w4tchd0g/phenix-1255-shield/ext_parts/3d/EVQ-Q2Y03W.step

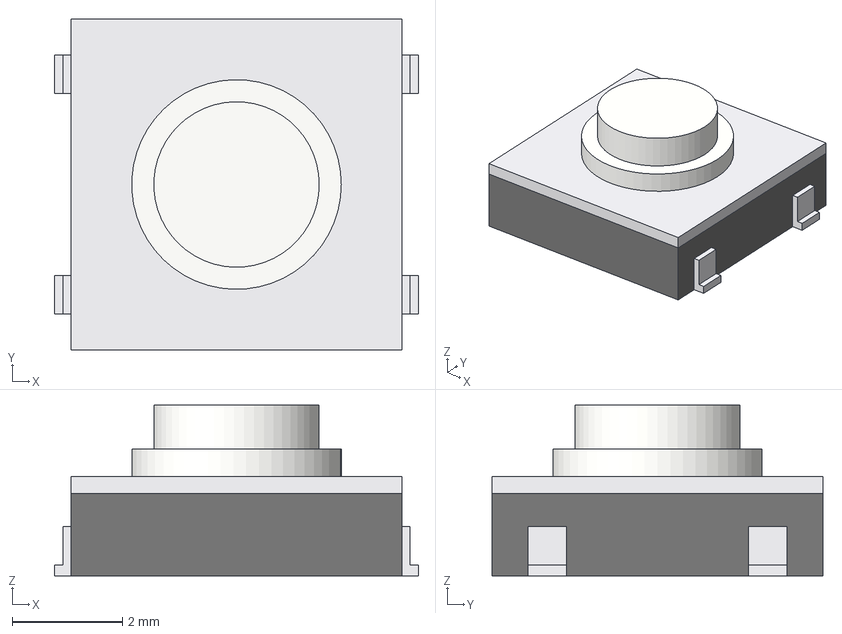
[picture p6: CAD file, 2026-11-12]
ext_parts/3d/EVQ-Q2Y03W.step
6.60 x 6.00 x 3.10 mm
base
cover
push_plate
terminals
