w4tchd0g/phenix-1255-shield/ext_parts/3d/SMA_Samtec_SMA-J-P-H-ST-EM1_EdgeMount.step

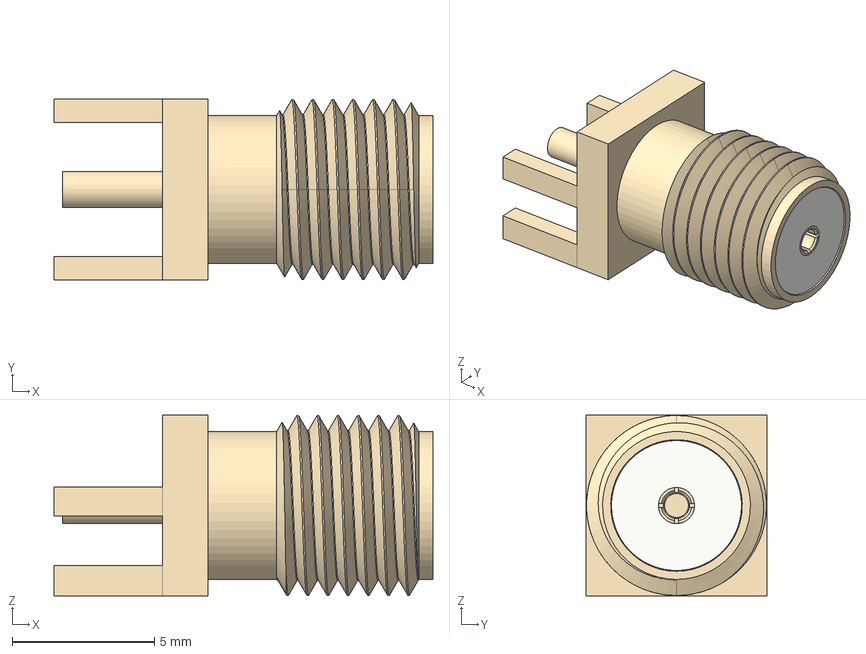
[picture p7: CAD file, 2026-11-12]
ext_parts/3d/SMA_Samtec_SMA-J-P-H-ST-EM1_EdgeMount.step
13.3 x 6.35 x 6.35 mm
insulator_PTFE
socket_contact
