w4tchd0g/phenix-1255-shield/ext_parts/3d/CONSMA001-SMD-G.step

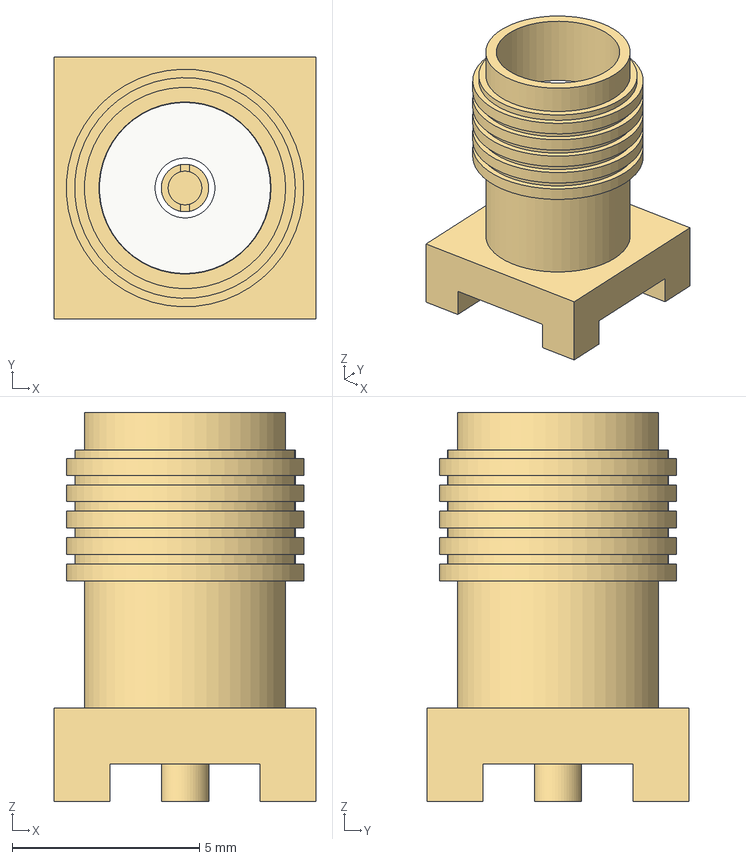
[picture p8: CAD file, 2026-11-12]
ext_parts/3d/CONSMA001-SMD-G.step
7.00 x 7.00 x 10.4 mm
insulator_PTFE
socket_contact
