w4tchd0g/phenix-1255-shield/ext_parts/3d/Display_128x64_096_I2C.stp

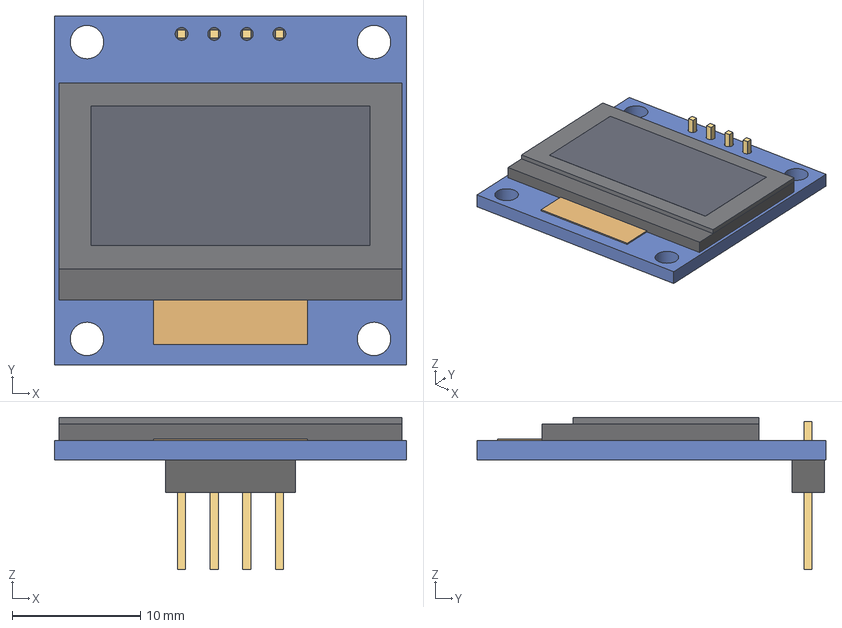
[picture p9: CAD file, 2026-11-12]
ext_parts/3d/Display_128x64_096_I2C.stp
27.4 x 27.2 x 11.9 mm
pcb
glass
cover_glass
active_area
flex
header_body
header_pins
