w4tchd0g/phenix-1255-shield/ext_parts/3d/TA0655A.stp

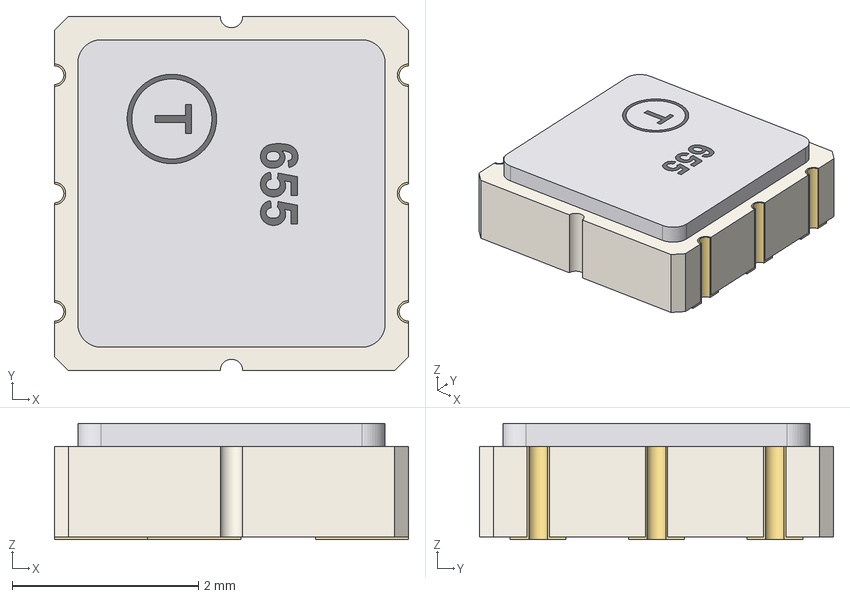
[picture p10: CAD file, 2026-11-12]
ext_parts/3d/TA0655A.stp
3.80 x 3.80 x 1.25 mm
lid
terminals
marking
