w4tchd0g/phenix-1255-shield/ext_parts/3d/TG2520SMN.step

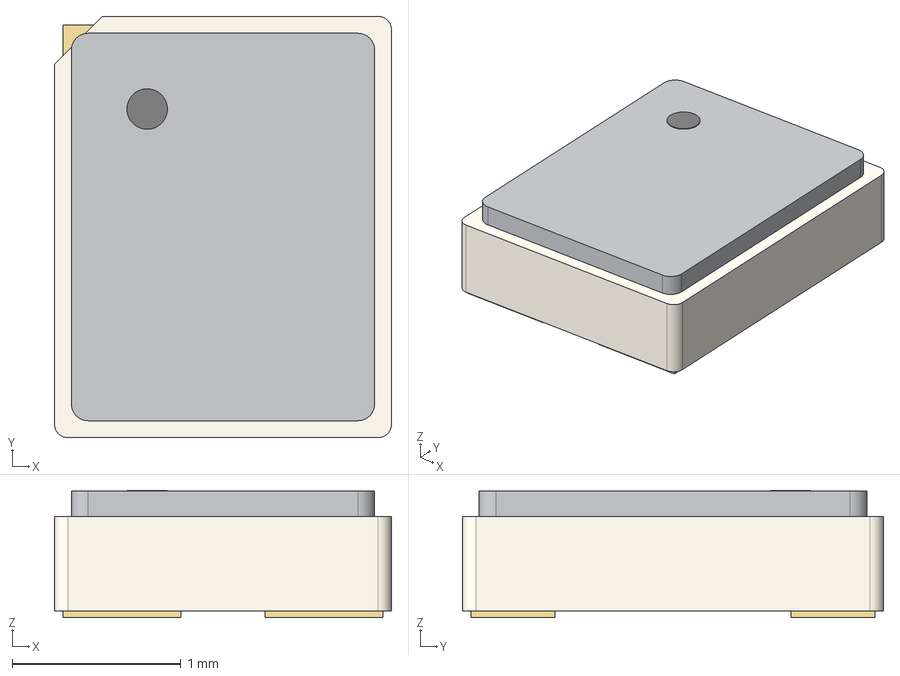
[picture p11: CAD file, 2026-11-12]
ext_parts/3d/TG2520SMN.step
2.00 x 2.50 x 0.755 mm
lid
pin1_mark
pins
