w4tchd0g/phenix-1255-shield/ext_parts/3d/LFCN-490+.step

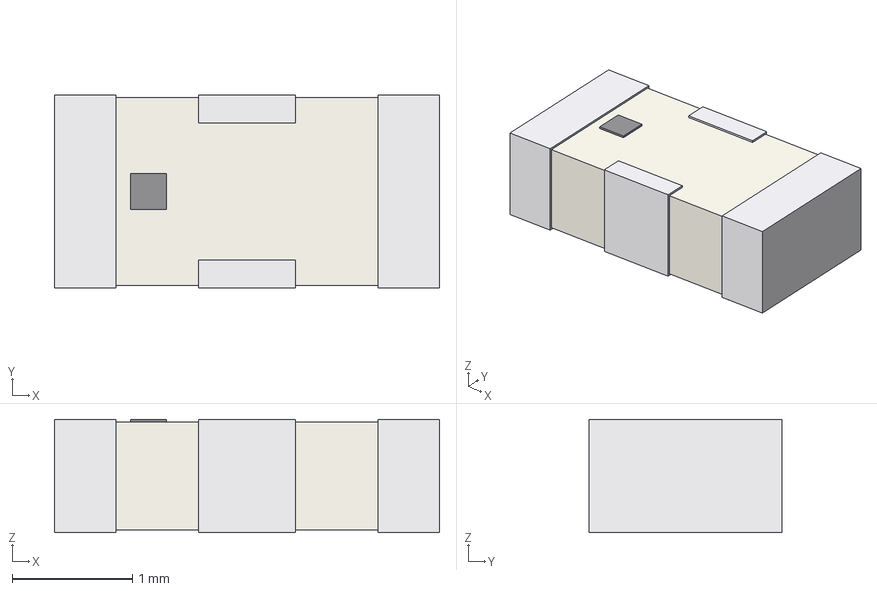
[picture p12: CAD file, 2026-11-12]
ext_parts/3d/LFCN-490+.step
3.20 x 1.60 x 0.94 mm
terminals
index
