w4tchd0g/phenix-1255-shield/phenix-1255-shield.kicad_pcb

## KiCad design phenix-1255-shield.kicad_pcb (2026-11-12)

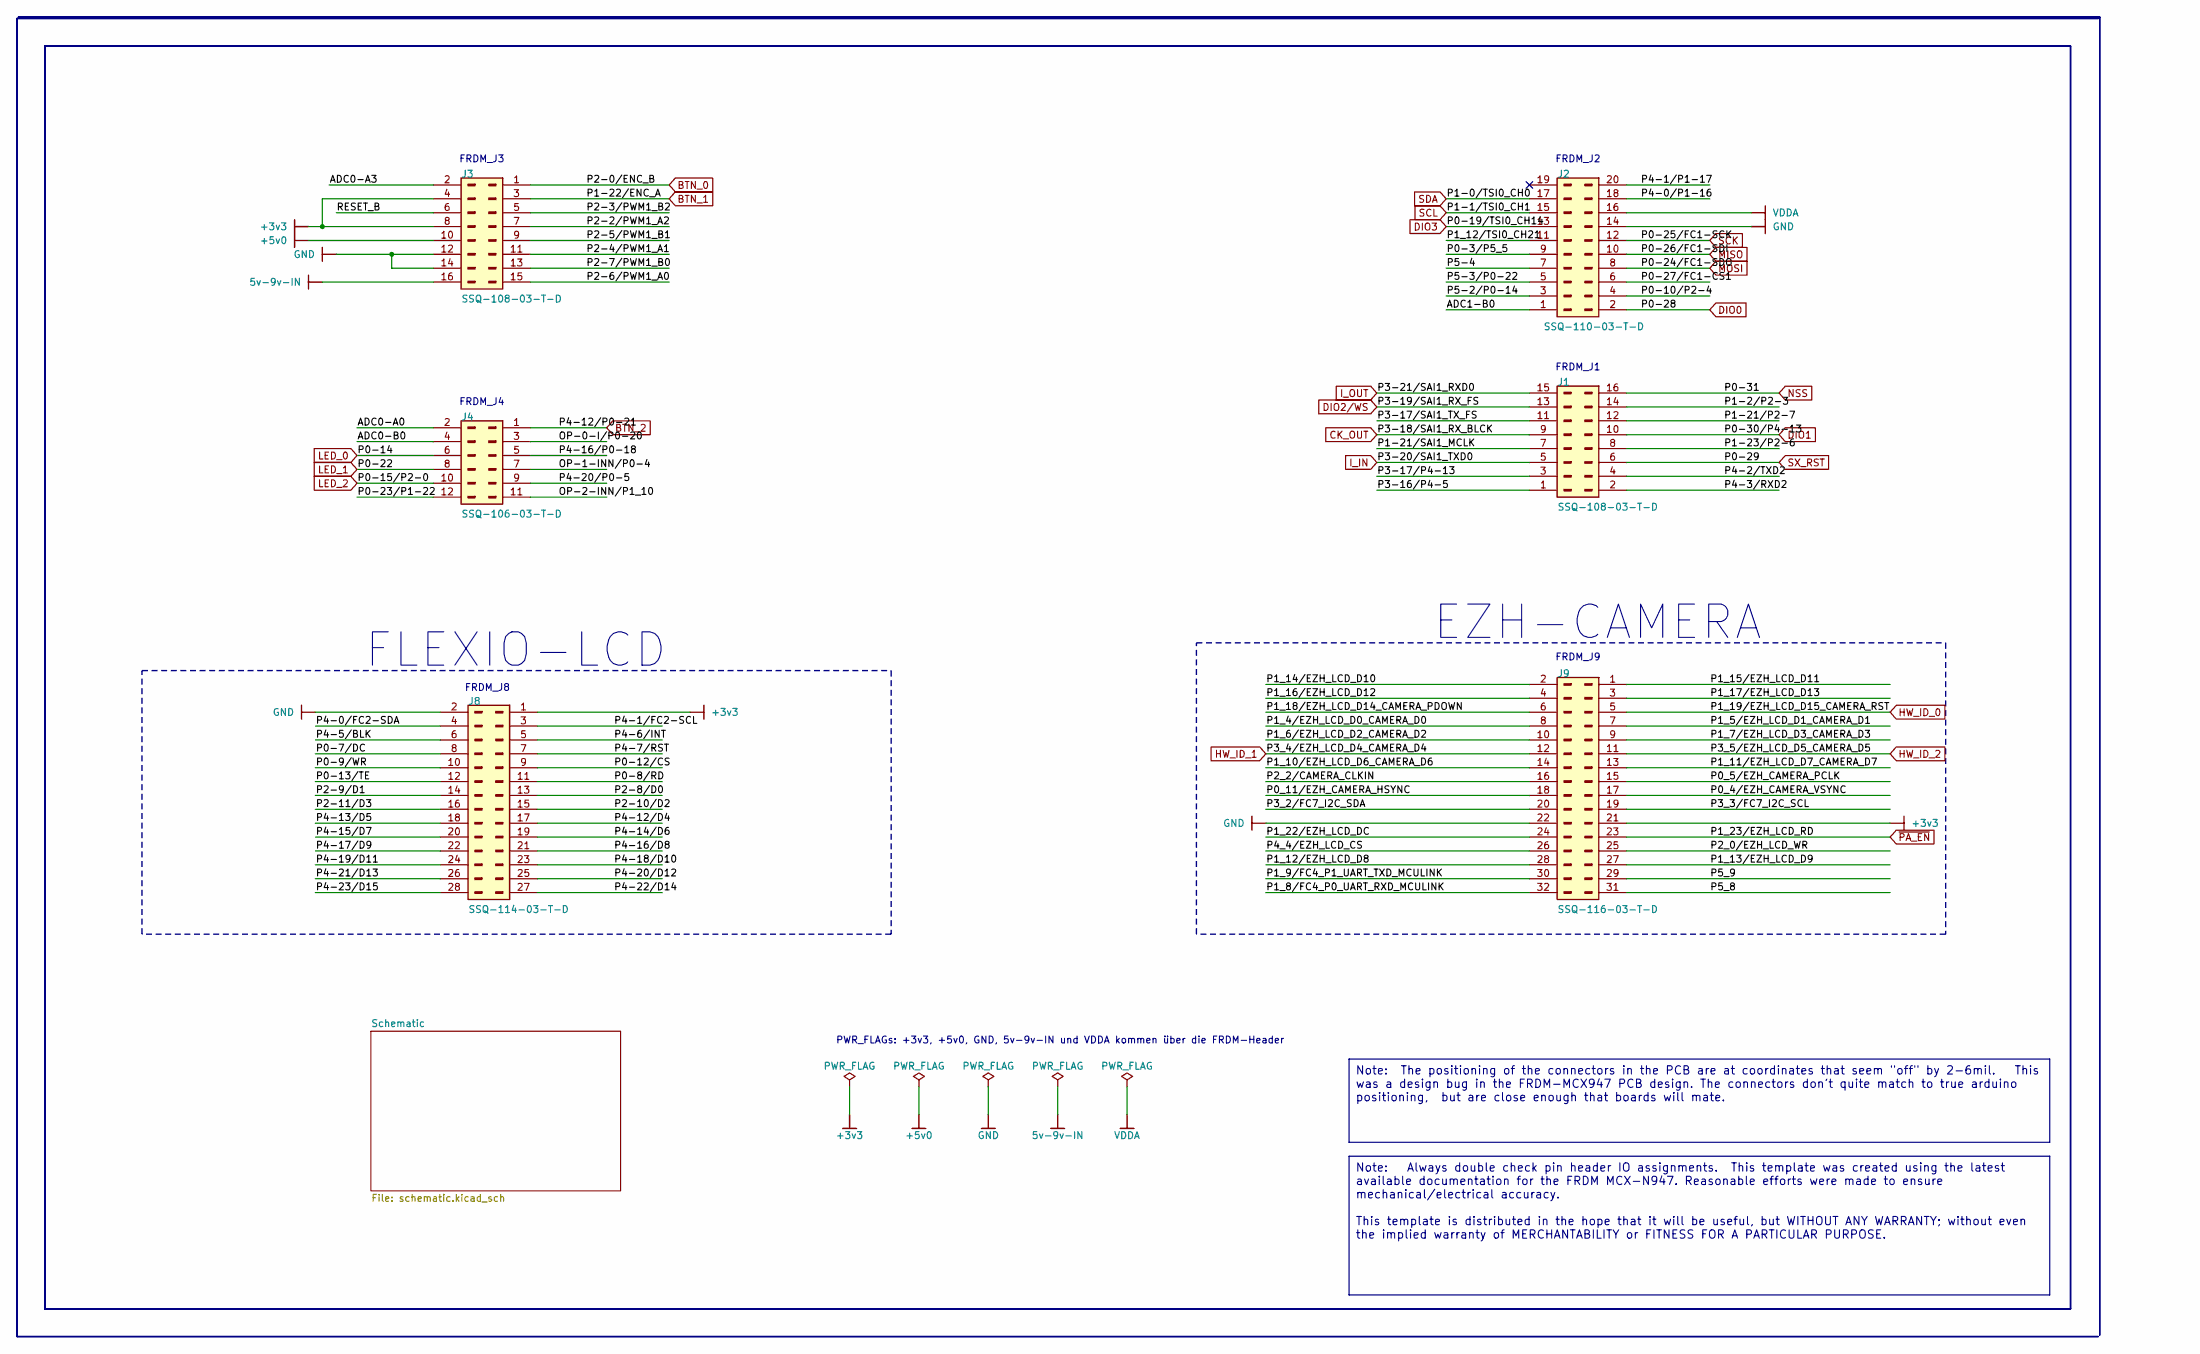
[picture p13: schematic phenix-1255-shield.kicad_sch]

Parts:
J1, J3: SSQ-108-03-T-D; MANUFACTURER PART NUMBER SSQ-108-03-T-D
J2: SSQ-110-03-T-D; MANUFACTURER PART NUMBER SSQ-110-23-T-D
J4: SSQ-106-03-T-D; MANUFACTURER PART NUMBER SSQ-106-03-T-D
J8: SSQ-114-03-T-D; MANUFACTURER PART NUMBER SSQ-114-03-T-D
J9: SSQ-116-03-T-D; MANUFACTURER P/N SSQ-116-03-T-D

Connections:
5v-9v-IN: J3.16
+3v3: J3.4, J3.8, J8.1, J9.21; also elsewhere on the board
+5v0: J3.10; also elsewhere on the board
/ADC0-A0: J4.2
/ADC0-A3: J3.2
/ADC0-B0: J4.4
/ADC1-B0: J2.1
/OP-0-I/P0-20: J4.3
/OP-1-INN/P0-4: J4.7
/OP-2-INN/P1_10: J4.11
/P0-3/P5_5: J2.9
/P0-7/DC: J8.8
/P0-8/RD: J8.11
/P0-9/WR: J8.10
/P0-10/P2-4: J2.4
/P0-12/CS: J8.9
/P0-13/TE: J8.12
/P0-23/P1-22: J4.12
/P0-27/FC1-CS1: J2.6
/P0_4/EZH_CAMERA_VSYNC: J9.17
/P0_5/EZH_CAMERA_PCLK: J9.15
/P0_11/EZH_CAMERA_HSYNC: J9.18
/P1-2/P2-3: J1.14
/P1-21/P2-7: J1.12
/P1-21/SAI1_MCLK: J1.7
/P1-23/P2-6: J1.8
/P1_4/EZH_LCD_D0_CAMERA_D0: J9.8
/P1_5/EZH_LCD_D1_CAMERA_D1: J9.7
/P1_6/EZH_LCD_D2_CAMERA_D2: J9.10
/P1_7/EZH_LCD_D3_CAMERA_D3: J9.9
/P1_8/FC4_P0_UART_RXD_MCULINK: J9.32
/P1_9/FC4_P1_UART_TXD_MCULINK: J9.30
/P1_10/EZH_LCD_D6_CAMERA_D6: J9.14
/P1_11/EZH_LCD_D7_CAMERA_D7: J9.13
/P1_12/EZH_LCD_D8: J9.28
/P1_12/TSI0_CH21: J2.11
/P1_13/EZH_LCD_D9: J9.27
/P1_14/EZH_LCD_D10: J9.2
/P1_15/EZH_LCD_D11: J9.1
/P1_16/EZH_LCD_D12: J9.4
/P1_17/EZH_LCD_D13: J9.3
/P1_18/EZH_LCD_D14_CAMERA_PDOWN: J9.6
/P1_22/EZH_LCD_DC: J9.24
/P2-2/PWM1_A2: J3.7
/P2-3/PWM1_B2: J3.5
/P2-4/PWM1_A1: J3.11
/P2-5/PWM1_B1: J3.9
/P2-6/PWM1_A0: J3.15
/P2-7/PWM1_B0: J3.13
/P2-8/D0: J8.13
/P2-9/D1: J8.14
/P2-10/D2: J8.15
/P2-11/D3: J8.16
/P2_0/EZH_LCD_WR: J9.25
/P2_2/CAMERA_CLKIN: J9.16
/P3-16/P4-5: J1.1
/P3-17/P4-13: J1.3
/P3-17/SAI1_TX_FS: J1.11
/P3_2/FC7_I2C_SDA: J9.20
/P3_3/FC7_I2C_SCL: J9.19
/P4-0/FC2-SDA: J8.4
/P4-0/P1-16: J2.18
/P4-1/FC2-SCL: J8.3
/P4-1/P1-17: J2.20
/P4-2/TXD2: J1.4
/P4-3/RXD2: J1.2
/P4-5/BLK: J8.6
/P4-6/INT: J8.5
/P4-7/RST: J8.7
/P4-12/D4: J8.17
/P4-13/D5: J8.18
/P4-14/D6: J8.19
/P4-15/D7: J8.20
/P4-16/D8: J8.21
/P4-16/P0-18: J4.5
/P4-17/D9: J8.22
/P4-18/D10: J8.23
/P4-19/D11: J8.24
/P4-20/D12: J8.25
/P4-20/P0-5: J4.9
/P4-21/D13: J8.26
/P4-22/D14: J8.27
/P4-23/D15: J8.28
/P4_4/EZH_LCD_CS: J9.26
/P5-2/P0-14: J2.3
/P5-3/P0-22: J2.5
/P5-4: J2.7
/P5_8: J9.31
/P5_9: J9.29
/RESET_B: J3.6
BTN_0: J3.1; also elsewhere on the board
BTN_1: J3.3; also elsewhere on the board
BTN_2: J4.1; also elsewhere on the board
CK_OUT: J1.9; also elsewhere on the board
DIO0: J2.2; also elsewhere on the board
DIO1: J1.10; also elsewhere on the board
DIO2/WS: J1.13; also elsewhere on the board
DIO3: J2.13; also elsewhere on the board
GND: J2.14, J3.12, J3.14, J8.2, J9.22; also elsewhere on the board
HW_ID_0: J9.5; also elsewhere on the board
HW_ID_1: J9.12; also elsewhere on the board
HW_ID_2: J9.11; also elsewhere on the board
I_IN: J1.5; also elsewhere on the board
I_OUT: J1.15; also elsewhere on the board
LED_0: J4.6; also elsewhere on the board
LED_1: J4.8; also elsewhere on the board
LED_2: J4.10; also elsewhere on the board
MISO: J2.10; also elsewhere on the board
MOSI: J2.8; also elsewhere on the board
NSS: J1.16; also elsewhere on the board
SCK: J2.12; also elsewhere on the board
SCL: J2.15; also elsewhere on the board
SDA: J2.17; also elsewhere on the board
SX_RST: J1.6; also elsewhere on the board
VDDA: J2.16
~PA_EN: J9.23; also elsewhere on the board

Notes on the sheet:
FRDM_J2
FRDM_J8
PWR_FLAGs: +3v3, +5v0, GND, 5v-9v-IN und VDDA kommen über die FRDM-Header
FRDM_J9
FRDM_J4
FRDM_J1
FLEXIO-LCD
FRDM_J3
EZH-CAMERA
Note: Always double check pin header IO assignments. This template was created using the latest available documentation for the FRDM MCX-N947. Reasonable efforts were made to ensure mechanical/electrical accuracy. This template is distributed in the hope that it will be useful, but WITHOUT ANY WARR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
Note: The positioning of the connectors in the PCB are at coordinates that seem "off" by 2-6mil. This was a design bug in the FRDM-MCX947 PCB design. The connectors don't quite match to true arduino positioning, but are close enough that boards will mate.

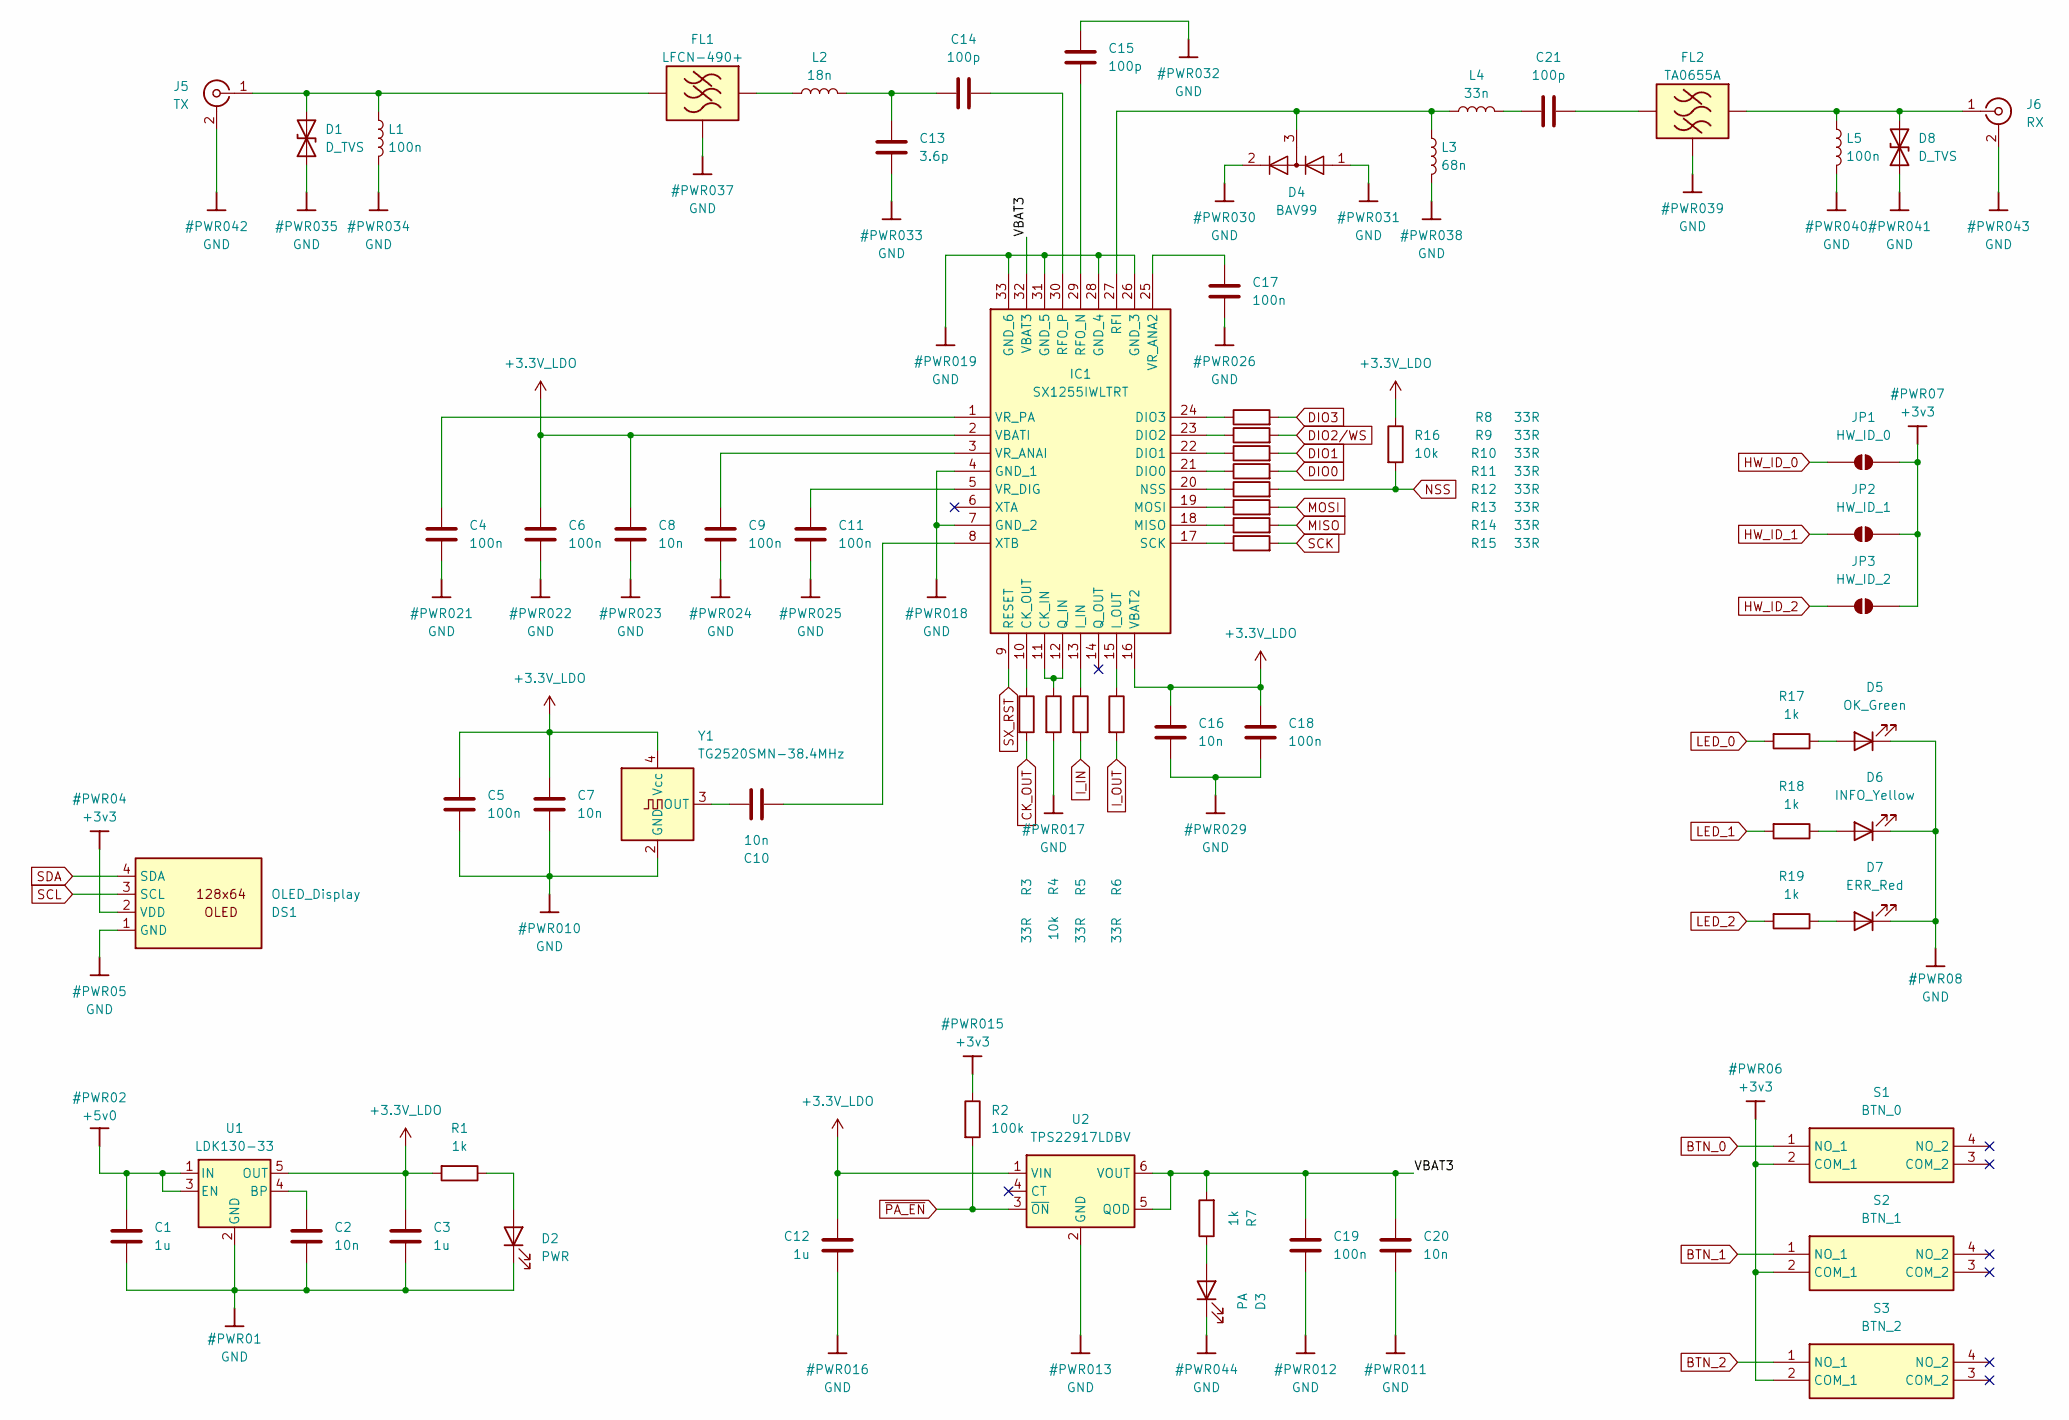
[picture p14: schematic schematic.kicad_sch, phenix-1255-shield]

Parts:
C1, C3, C12: 1u; C_0603_1608Metric; MPN CL10A105KL8NNNC; LCSC C478859
C2, C7, C8, C10, C16, C20: 10n; C_0603_1608Metric; MPN GRM1885C1H103JA01J; LCSC C2215227
C4, C5, C6, C9, C11, C17, C18, C19: 100n; C_0603_1608Metric; MPN CL10B104KB8NNNC; LCSC C1591
C13: 3.6p; C_0603_1608Metric; MPN CC0603BRNPO9BN3R6; LCSC C519106
C14, C15, C21: 100p; C_0603_1608Metric; MPN CL10C101JB8NNNC; LCSC C14858
D1, D8: D_TVS; D_SOD-882; MPN PESD5V0F1BL,315; LCSC C45961
D2: PWR; LED_0603_1608Metric; MPN 150060GS75000; LCSC 0
D3: PA; LED_0603_1608Metric; MPN 150060RS75000; LCSC 0
D4: BAV99; SOT-23; MPN BAV99,215; LCSC C2500
D5: OK_Green; LED_0603_1608Metric; MPN 150060GS75000; LCSC 0
D6: INFO_Yellow; LED_0603_1608Metric; MPN 150060YS75000; LCSC 0
D7: ERR_Red; LED_0603_1608Metric; MPN 150060RS75000; LCSC 0
DS1: OLED_Display; Display_128x64_096_I2C
FL1: LFCN-490+; LFCN490
FL2: TA0655A; MPN TA0655A
IC1: SX1255IWLTRT; QFN50P500X500X80-33N-D; MPN SX1255IWLTRT; LCSC C89372
J5: TX; CONSMA001-SMD-G_EdgeHybrid
J6: RX; CONSMA001-SMD-G_EdgeHybrid
JP1: HW_ID_0; SolderJumper-2_P1.3mm_Open_RoundedPad1.0x1.5mm
JP2: HW_ID_1; SolderJumper-2_P1.3mm_Open_RoundedPad1.0x1.5mm
JP3: HW_ID_2; SolderJumper-2_P1.3mm_Open_RoundedPad1.0x1.5mm
L1, L5: 100n; L_0603_1608Metric; MPN LQW18ANR10G00D; LCSC C98088
L2: 18n; L_0603_1608Metric; MPN LQW18AN18NG00D; LCSC C86133
L3: 68n; L_0603_1608Metric; MPN LQW18AN68NG00D; LCSC C86135
L4: 33n; L_0603_1608Metric; MPN LQW18AN33NJ10D; LCSC C701171
R1, R7, R17, R18, R19: 1k; R_0603_1608Metric; MPN 0603WAF1001T5E; LCSC C21190
R2: 100k; R_0603_1608Metric; MPN 0603WAF1003T5E; LCSC C25803
R3, R5, R6, R8, R9, R10, R11, R12, R13, R14, R15: 33R; R_0603_1608Metric; MPN 0603WAF330JT5E
R4, R16: 10k; R_0603_1608Metric; MPN 0603WAF1002T5E; LCSC C25804
S1: BTN_0; EVQQ2; MPN EVQQ2Y03W; LCSC C2828255
S2: BTN_1; EVQQ2; MPN EVQQ2Y03W; LCSC C2828255
S3: BTN_2; EVQQ2; MPN EVQQ2Y03W; LCSC C2828255
U1: LDK130-33; SOT-23-5; MPN LDK130M33R; LCSC C2969807
U2: TPS22917LDBV; SOT-23-6; MPN TPS22917LDBVR; LCSC C3235537
Y1: TG2520SMN-38.4MHz; Oscillator_SMD_SeikoEpson_TG2520SMN-xxx-xxxxxx-4Pin_2.5x2.0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; MPN TG2520SMN 38.4000M-MCGNNM3; LCSC C20341495

Connections:
+3.3V_LDO: C3.1, C5.1, C6.1, C7.1, C8.1, C12.1, C16.1, C18.1, IC1.2 (VBATI), IC1.16 (VBAT2), R1.2, R16.1, U1.5 (OUT), U2.1 (VIN), Y1.4 (Vcc)
+3v3: DS1.2 (VDD), JP1.2 (B), JP2.2 (B), JP3.2 (B), R2.1, S1.2 (COM_1), S2.2 (COM_1), S3.2 (COM_1); also elsewhere on the board
+5v0: C1.1, U1.1 (IN), U1.3 (EN); also elsewhere on the board
/Schematic/VBAT3: C19.1, C20.1, IC1.32 (VBAT3), R7.2, U2.5 (QOD), U2.6 (VOUT)
BTN_0: S1.1 (NO_1); also elsewhere on the board
BTN_1: S2.1 (NO_1); also elsewhere on the board
BTN_2: S3.1 (NO_1); also elsewhere on the board
CK_OUT: R3.2; also elsewhere on the board
DIO0: R11.2; also elsewhere on the board
DIO1: R10.2; also elsewhere on the board
DIO2/WS: R9.2; also elsewhere on the board
DIO3: R8.2; also elsewhere on the board
GND: C1.2, C2.2, C3.2, C4.2, C5.2, C6.2, C7.2, C8.2, C9.2, C11.2, C12.2, C13.2, C15.2, C16.2, C17.2, C18.2, C19.2, C20.2, D1.1 (A1), D2.1 (K), D3.1 (K), D4.1 (K), D4.2 (A), D5.1 (K), D6.1 (K), D7.1 (K), D8.1 (A1), DS1.1 (GND), FL1.2 (GROUND_1), FL1.4 (GROUND_2), FL2.1 (A_GND), FL2.3 (C_GND), FL2.4 (D_GND), FL2.6 (F_GND), IC1.4 (GND_1), IC1.7 (GND_2), IC1.26 (GND_3), IC1.28 (GND_4), IC1.31 (GND_5), IC1.33 (GND_6), J5.2 (Ext), J6.2 (Ext), L1.2, L3.2, L5.2, R4.2, U1.2 (GND), U2.2 (GND), Y1.2 (GND); also elsewhere on the board
HW_ID_0: JP1.1 (A); also elsewhere on the board
HW_ID_1: JP2.1 (A); also elsewhere on the board
HW_ID_2: JP3.1 (A); also elsewhere on the board
I_IN: R5.2; also elsewhere on the board
I_OUT: R6.2; also elsewhere on the board
LED_0: R17.2; also elsewhere on the board
LED_1: R18.2; also elsewhere on the board
LED_2: R19.2; also elsewhere on the board
MISO: R14.2; also elsewhere on the board
MOSI: R13.2; also elsewhere on the board
NSS: R12.2, R16.2; also elsewhere on the board
unnamed: C13.1, C14.1, L2.2
unnamed: C21.1, L4.2
unnamed: D1.2 (A2), FL1.3 (RF_OUT), J5.1 (In), L1.1
unnamed: D2.2 (A), R1.1
unnamed: D3.2 (A), R7.1
unnamed: D5.2 (A), R17.1
unnamed: D6.2 (A), R18.1
unnamed: D7.2 (A), R19.1
unnamed: D8.2 (A2), FL2.2 (B_IN), J6.1 (In), L5.1
unnamed: FL1.1 (RF_IN), L2.1
unnamed: C21.2, FL2.5 (E_OUT)
unnamed: IC1.11 (CK_IN), IC1.12 (Q_IN), R4.1
unnamed: IC1.10 (CK_OUT), R3.1
unnamed: IC1.21 (DIO0), R11.1
unnamed: IC1.22 (DIO1), R10.1
unnamed: IC1.23 (DIO2), R9.1
unnamed: IC1.24 (DIO3), R8.1
unnamed: IC1.13 (I_IN), R5.1
unnamed: IC1.15 (I_OUT), R6.1
unnamed: IC1.18 (MISO), R14.1
unnamed: IC1.19 (MOSI), R13.1
unnamed: IC1.20 (NSS), R12.1
unnamed: D4.3 (K), IC1.27 (RFI), L3.1, L4.1
unnamed: C15.1, IC1.29 (RFO_N)
unnamed: C14.2, IC1.30 (RFO_P)
unnamed: IC1.17 (SCK), R15.1
unnamed: C17.1, IC1.25 (VR_ANA2)
unnamed: C9.1, IC1.3 (VR_ANAI)
unnamed: C11.1, IC1.5 (VR_DIG)
unnamed: C4.1, IC1.1 (VR_PA)
unnamed: C10.2, IC1.8 (XTB)
unnamed: C2.1, U1.4 (BP)
unnamed: C10.1, Y1.3 (OUT)
SCK: R15.2; also elsewhere on the board
SCL: DS1.3 (SCL); also elsewhere on the board
SDA: DS1.4 (SDA); also elsewhere on the board
SX_RST: IC1.9 (RESET); also elsewhere on the board
~PA_EN: R2.2, U2.3 (~ON); also elsewhere on the board

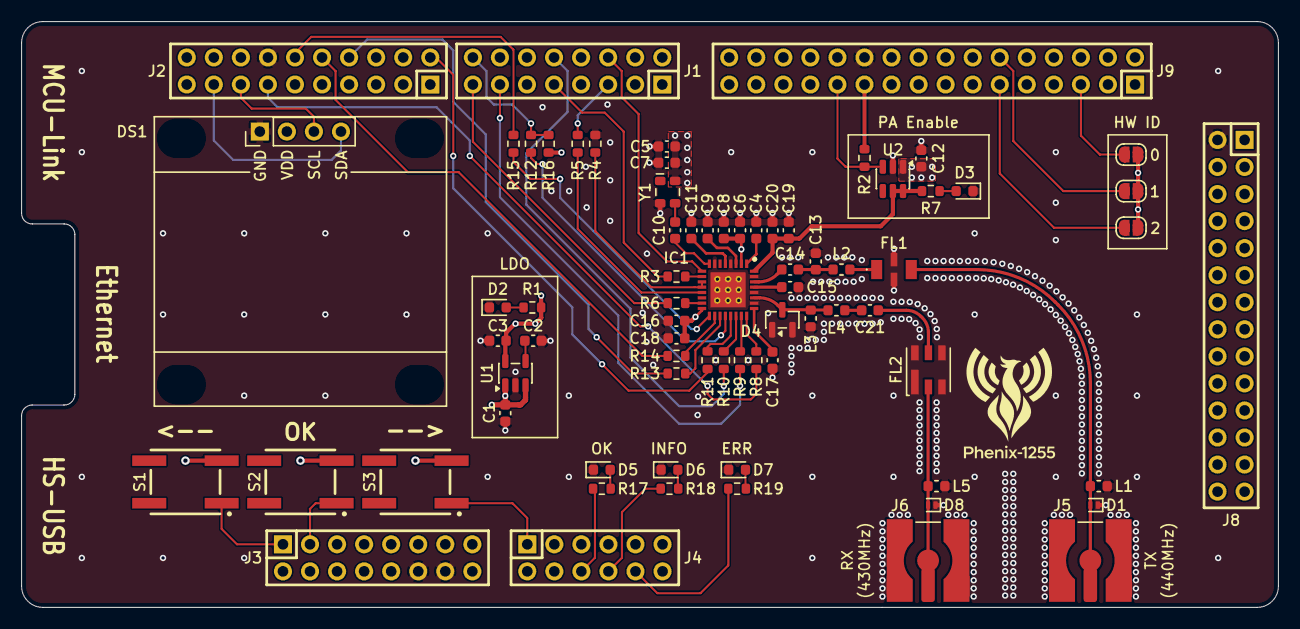
[picture p15: board phenix-1255-shield.kicad_pcb from above]

Board: 4 copper layers, 118.0 x 55.0 mm, 74 parts (0 on the bottom side), 62 nets.
