w4tchd0g/phenix-1255-shield/(notices)

Notices in the files:
phenix-1255-shield.kicad_pcb:
Based on Phenix-1255-HW, Copyright (c) Z32IT 2026
Modifications Copyright (c) w4tchd0g (DM5LF) 2026
